ovrEngineered/ovrBeaconGateway-btle-elec/bom/ovrBeaconGateway-btle_pricing.xlsx

Reference | Manufacturer | Man. Part Num. | Supplier | Supplier Part Num. | Quantity | Price (qty 1) | Subtotal (qty 1) | Price (qty 1000) | Subtotal (qty 1000)
U4 | Intersil | ISL32602EFBZ | Digi-Key | ISL32602EFBZ-ND | 1 | $3.18 | $3.18 | $1.680000 | $1.68
U5 | BlueGiga | BLE121LR-A-M256K | Digi-Key | 1446-1039-1-ND | 1 | $13.76 | $13.76 | $8.312320 | $8.31
J1 | Pulse Electronics | E6588-52L184-L | Digi-Key | 553-2265-ND | 1 | $1.40 | $1.40 | $0.774400 | $0.77
R8 R9 R6 R7 R10 R4 R5 | Vishay_Dale | CRCW060310K0FKEA | Digi-Key | 541-10.0KHCT-ND | 7 | $0.10 | $0.70 | $0.003610 | $0.03
U2 | Torex Semiconductor | XC6210B332MR-G | Digi-Key | 893-1075-1-ND | 1 | $0.88 | $0.88 | $0.351020 | $0.35
C1 C2 | Murata | GRM21BR71A106KE51L | Digi-Key | 490-3905-1-ND | 2 | $0.24 | $0.48 | $0.059340 | $0.12
D1 | Lite-On Inc | LTST-C193KGKT-5A | Digi-Key | 160-1828-1-ND | 1 | $0.41 | $0.41 | $0.075650 | $0.08
R1 R2 R3 | Vishay_Dale | CRCW0603402RFKEA | Digi-Key | 541-402HCT-ND | 3 | $0.10 | $0.30 | $0.005540 | $0.02
C4 C5 | Murata | GRM188R71C104KA01D | Digi-Key | 490-1532-1-ND | 2 | $0.10 | $0.20 | $0.004730 | $0.01
C3 | Murata | GRM188R71E103KA01D | Digi-Key | 490-1520-1-ND | 1 | $0.10 | $0.10 | $0.005760 | $0.01
U1 | Silicon Labs | SI7050-A20-IM | Digi-Key | 336-3118-5-ND | 1 | $1.25 | $1.25 | $0.939300 | $0.94
D2 | Lite-On Inc | LTST-C193TBKT-5A | Digi-Key | 160-1827-1-ND | 1 | $0.47 | $0.47 | $0.085700 | $0.09
D3 | Lite-On Inc | LTST-C193KRKT-5A | Digi-Key | 160-1830-1-ND | 1 | $0.41 | $0.41 | $0.075650 | $0.08
Q1 Q2 | International Rectifier | IRLML2402TRPBF | Digi-Key | IRLML2402PBFCT-ND | 2 | $0.43 | $0.86 | $0.105060 | $0.21
U3 | Lite-On | LTR-329ALS-01 | Digi-Key | 160-2160-1-ND | 1 | $1.08 | $1.08 | $0.431060 | $0.43
J2 | Amphenol | 20021111-00010T4LF | Digi-Key | 609-3712-ND | 1 | $0.64 | $0.64 | $0.330990 | $0.33
LightPipe | Visual Communications Company | LFB100CTP | Digi-Key | LFB100CTP-ND | 3 | $0.59 | $1.77 | $0.144040 | $0.43
Case | PolyCase | TF-1521TX | PolyCase | TF-1521TX | 1 | $1.09 | $1.09 | $0.560000 | $0.56
Case Top | PolyCase | C-1502-N | PolyCase | C-1502-N | 1 | $0.61 | $0.61 | $0.300000 | $0.30
Case Print/Machining | PolyCase |  |  |  | 1 |  |  | $3.090000 | $3.09
PCB |  |  |  |  | 1 | $1.00 | $1.00 | $1.000000 | $1.00
Assembly |  |  |  |  | 1 |  |  | $2.000000 | $2.00
 |  |  |  |  |  | Total: | $30.59 |  | $20.82
