ovrEngineered/ovrBeaconGateway-btle-elec/output/ovrBeaconGateway-btle_schematic.pdf

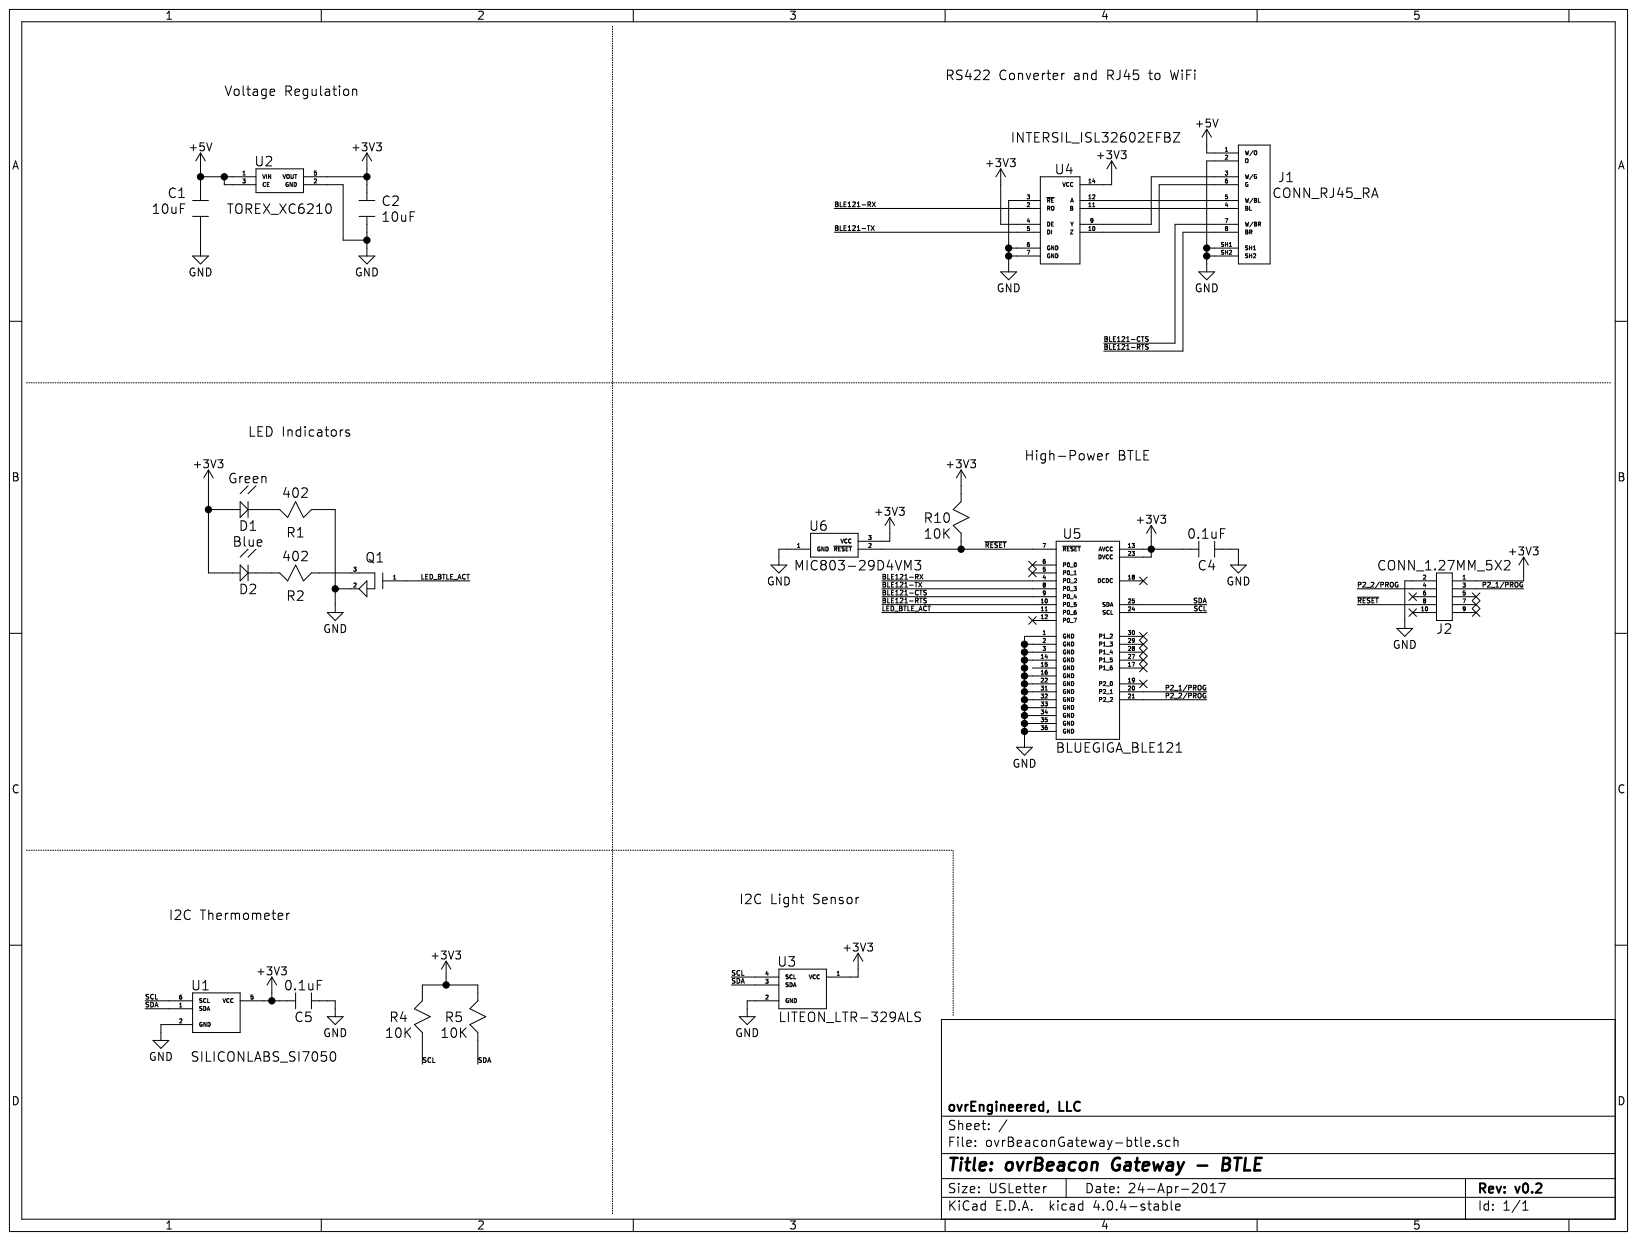
[picture p1: page 1]
