ovrEngineered/ovrBeaconGateway-btle-elec/output/ovrBeaconGateway-btle_layout.pdf

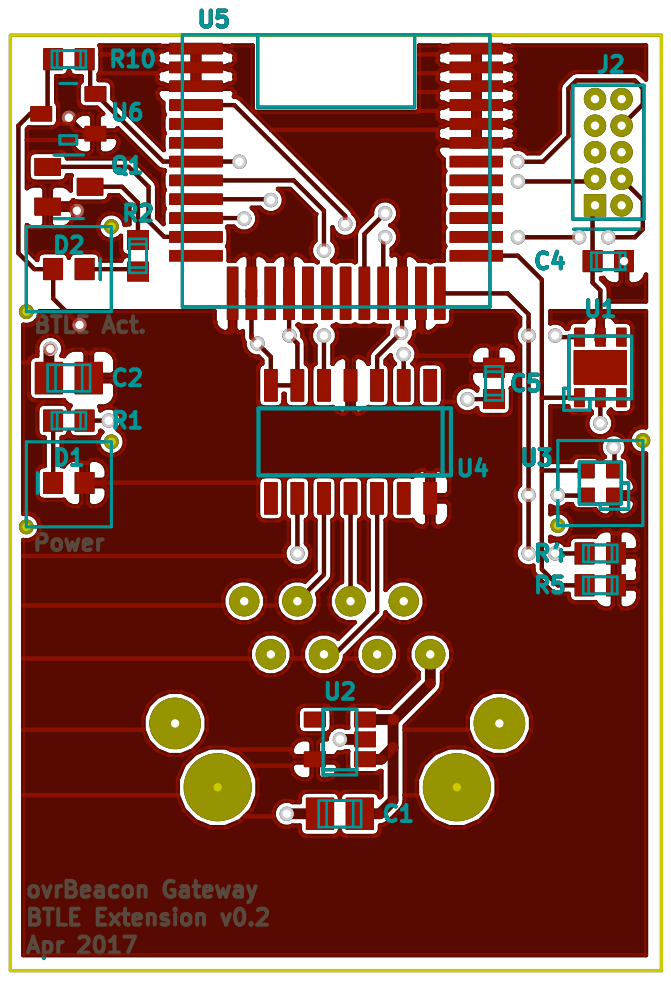
[picture p2: page 1]
