ovrEngineered/ovrBeaconGateway-btle-elec/ovrBeaconGateway-btle.kicad_pcb

## KiCad design ovrBeaconGateway-btle.kicad_pcb (2017-05-01)

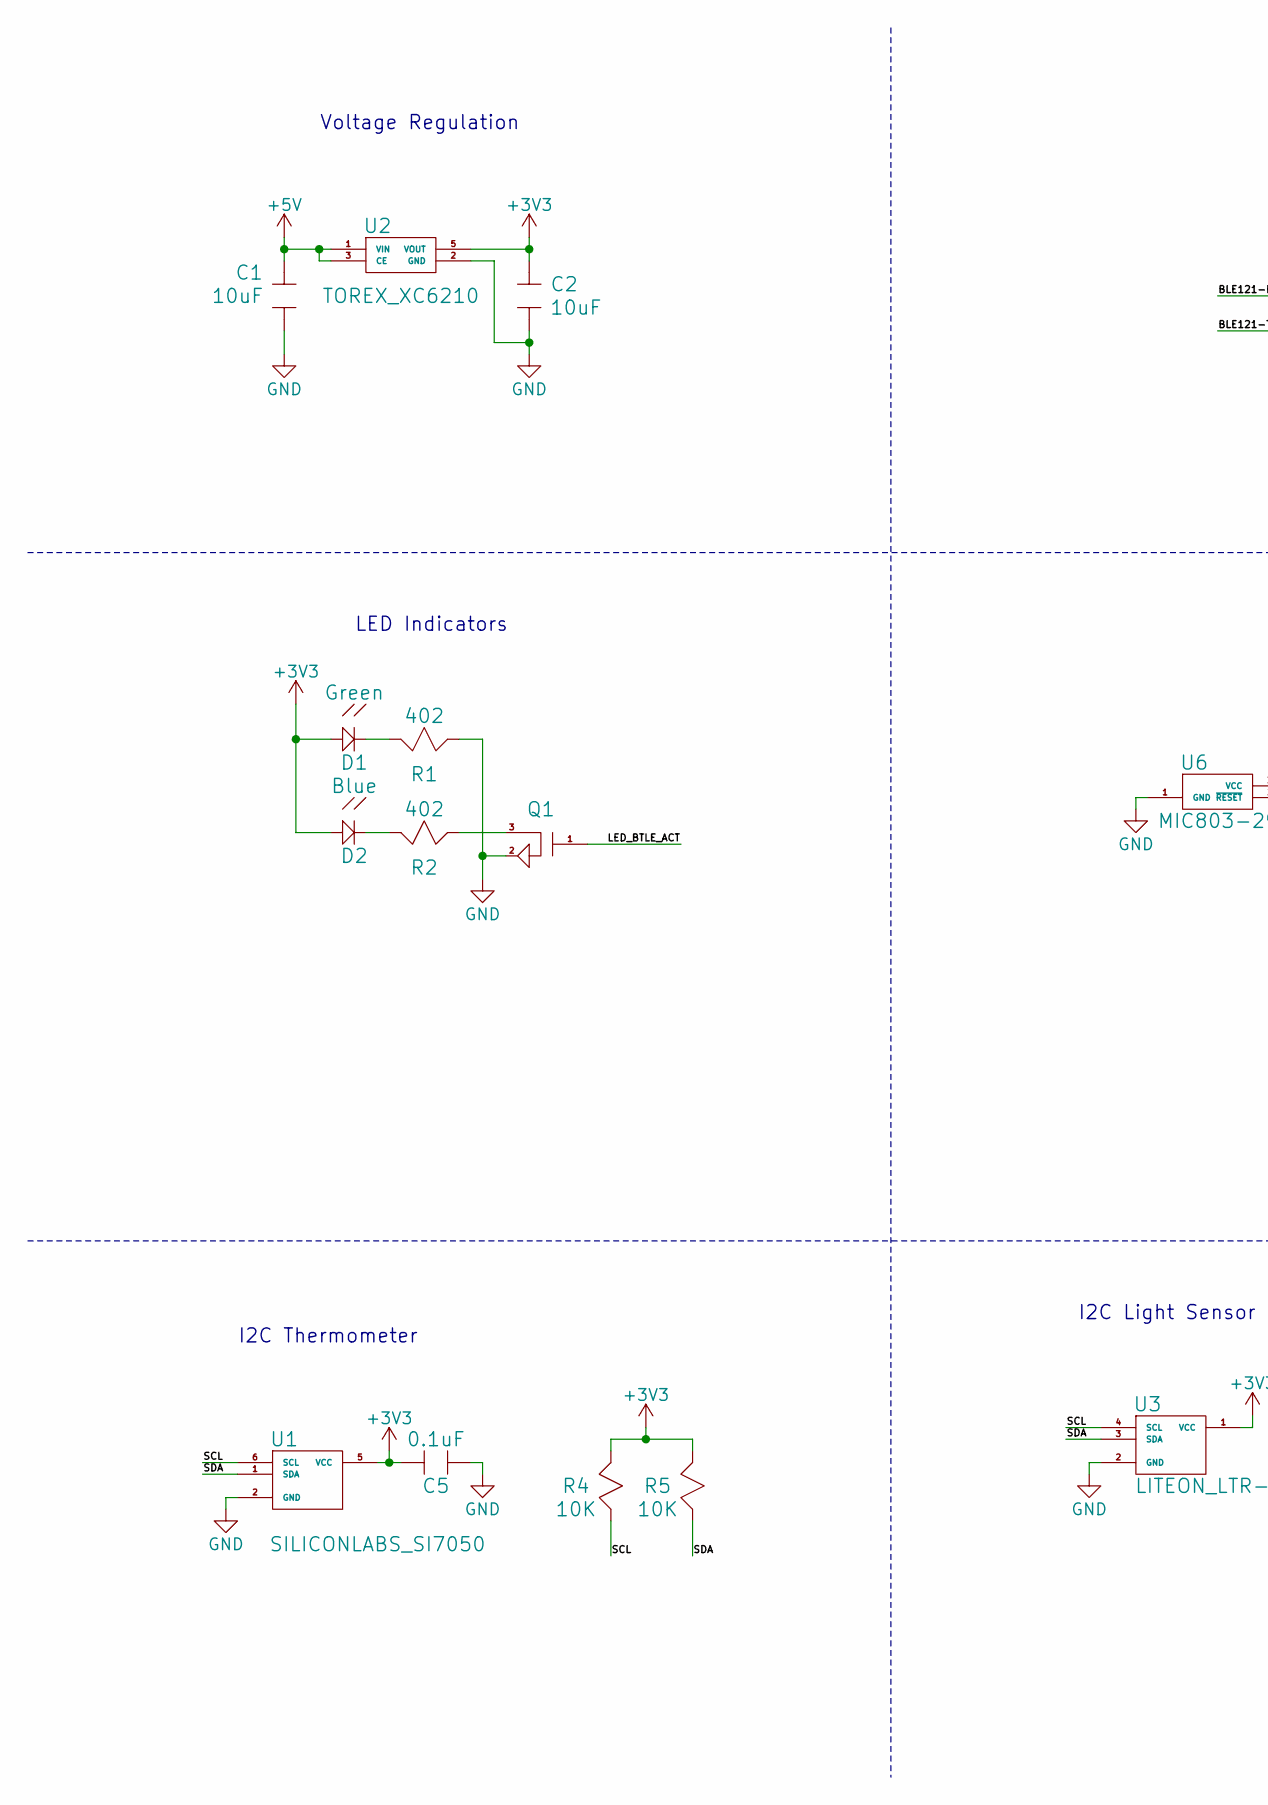
[picture p3: schematic ovrBeaconGateway-btle.sch, ovrBeacon Gateway - BTLE, part in row 1, column 1]

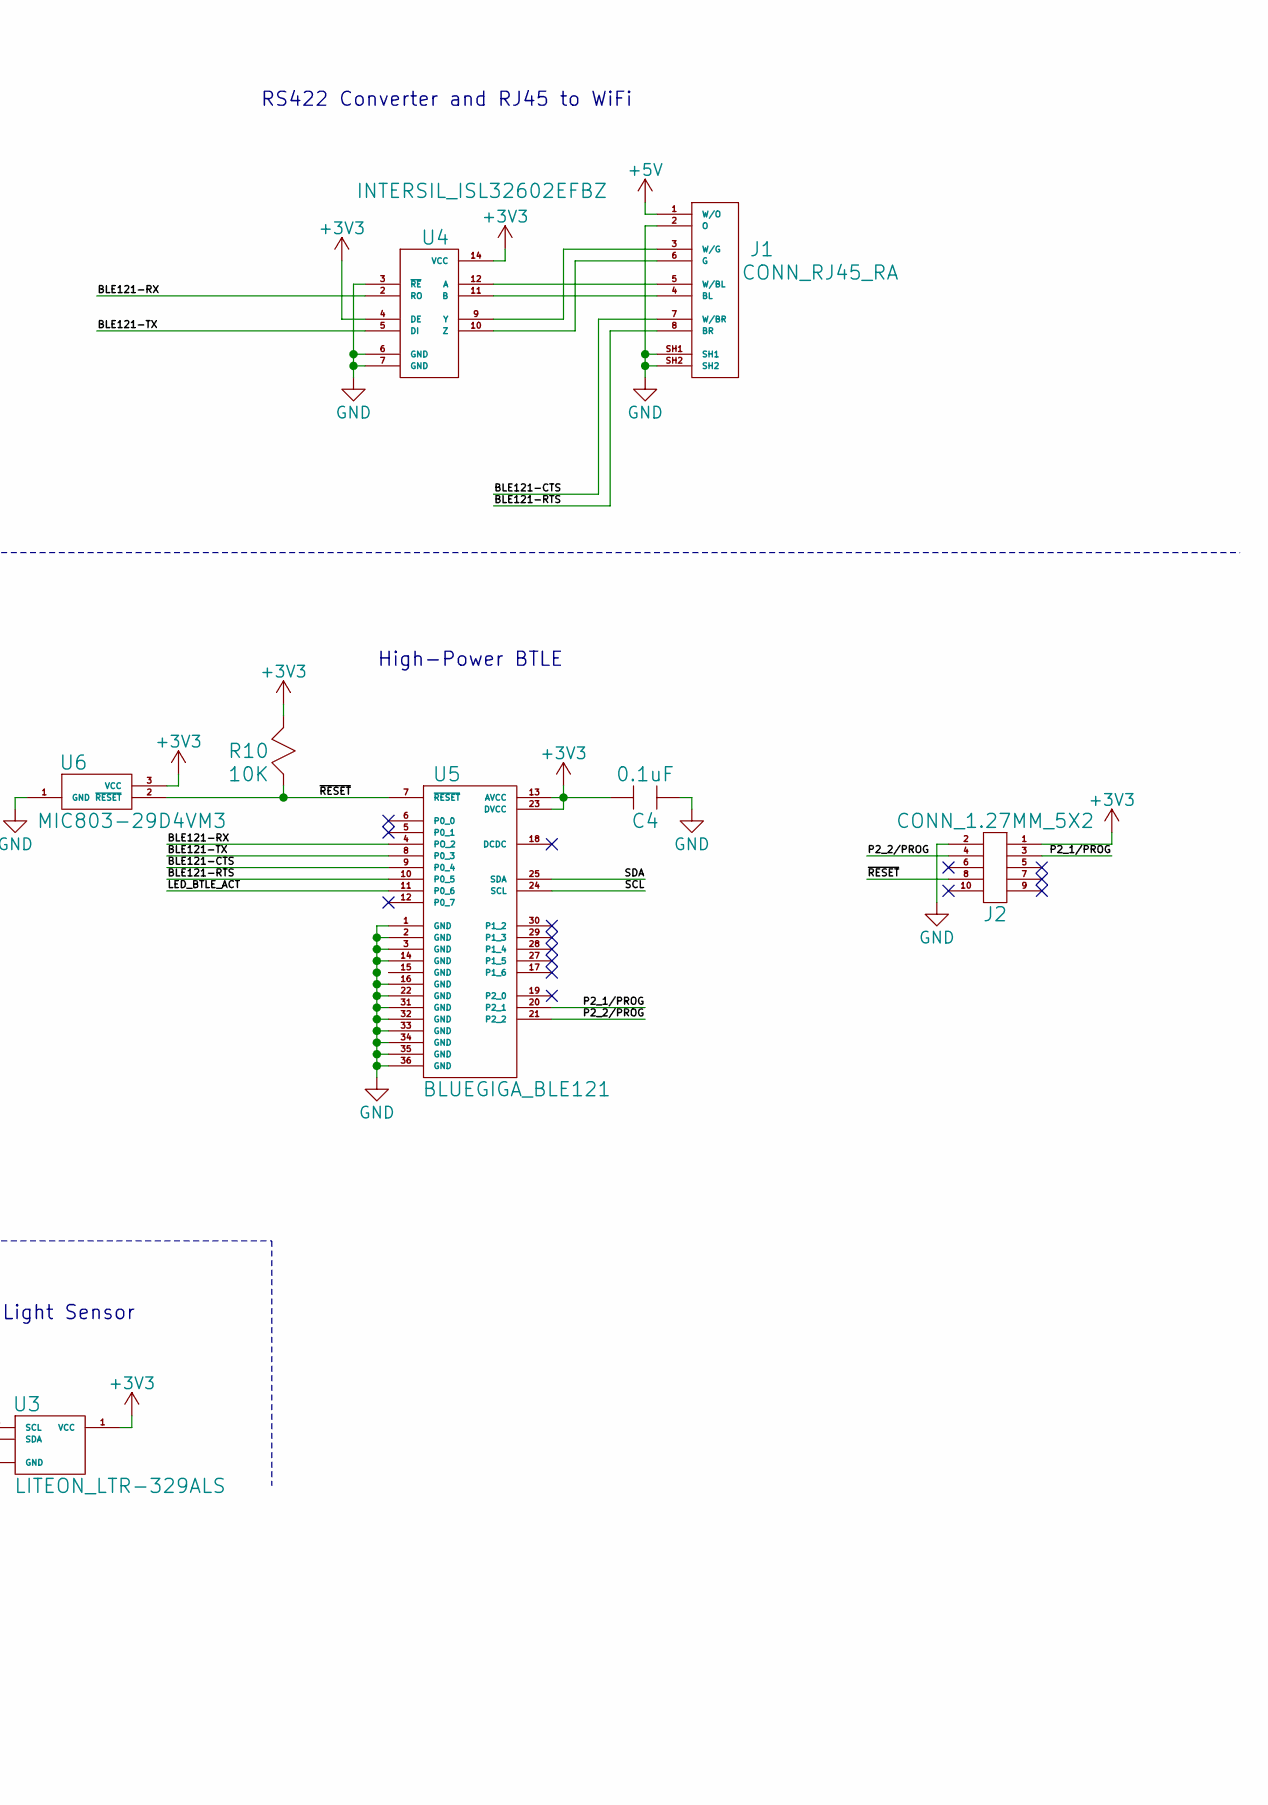
[picture p4: schematic ovrBeaconGateway-btle.sch, ovrBeacon Gateway - BTLE, part in row 1, column 2]

Parts:
C1, C2: C_10uF_10v_0805; C_0805; Man. Part Num. GRM21BR71A106KE51L
C4, C5: C_0.1uF_10v_0603; C_0603; Man. Part Num. GRM188R71C104KA01D
D1: LED_GREEN_0603; D_0603; Man. Part Num. LTST-C193KGKT-5A
D2: LED_BLUE_0603; D_0603; Man. Part Num. LTST-C193TBKT-5A
J1: CONN_RJ45_RA; RJ45_NOMAG_RA; Man. Part Num. E6588-52L184-L
J2: CONN_1.27MM_5X2; 20021111-00010T4LF; Man. Part Num. 20021111-00010T4LF
Q1: FET_N_1.2A_20V; Man. Part Num. IRLML2402TRPBF
R1, R2: R_402_1%_0603; R_0603; Man. Part Num. CRCW0603402RFKEA
R4, R5, R10: R_10K_1%_0603; R_0603; Man. Part Num. CRCW060310K0FKEA
U1: SILICONLABS_SI7050; Man. Part Num. SI7050-A20-IM
U2: TOREX_XC6210; SOT-25-5; Man. Part Num. XC6210B332MR-G
U3: LITEON_LTR-329ALS; Man. Part Num. LTR-329ALS-01
U4: INTERSIL_ISL32602EFBZ; SOIC-14; Man. Part Num. ISL32602EFBZ
U5: BLUEGIGA_BLE121; BLE121; Man. Part Num. BLE121LR-A-M256K
U6: MIC803-29D4VM3; SOT-23-3; Man. Part Num. MIC803-29D4VM3-TR

Connections:
+3V3: C2.1, C4.1, C5.1, D1.1, D2.1, J2.1, R4.1, R5.1, R10.1, U1.5 (VCC), U2.5 (VOUT), U3.1 (VCC), U4.4 (DE), U4.14 (VCC), U5.13 (AVCC), U5.23 (DVCC), U6.3 (VCC)
+5V: C1.1, J1.1 (W/O), U2.1 (VIN), U2.3 (CE)
/BLE121-CTS: J1.7 (W/BR), U5.9 (P0_4)
/BLE121-RTS: J1.8 (BR), U5.10 (P0_5)
/BLE121-RX: U4.2 (RO), U5.4 (PO_2)
/BLE121-TX: U4.5 (DI), U5.8 (P0_3)
/LED_BTLE_ACT: Q1.1, U5.11 (P0_6)
/P2_1/PROG: J2.3, U5.20 (P2_1)
/P2_2/PROG: J2.4, U5.21 (P2_2)
/SCL: R4.2, U1.6 (SCL), U3.4 (SCL), U5.24 (SCL)
/SDA: R5.2, U1.1 (SDA), U3.3 (SDA), U5.25 (SDA)
/~RESET: J2.8, R10.2, U5.7 (~RESET), U6.2 (~RESET)
GND: C1.2, C2.2, C4.2, C5.2, J1.2 (O), J1.SH1, J1.SH2, J2.2, Q1.2, R1.1, U1.2 (GND), U2.2 (GND), U3.2 (GND), U4.3 (~RE), U4.6 (GND), U4.7 (GND), U5.1 (GND), U5.2 (GND), U5.3 (GND), U5.14 (GND), U5.16 (GND), U5.22 (GND), U5.31 (GND), U5.32 (GND), U5.33 (GND), U5.34 (GND), U5.35 (GND), U5.36 (GND), U6.1 (GND)
unnamed: D1.2, R1.2
unnamed: D2.2, R2.2
unnamed: J1.3 (W/G), U4.9 (Y)
unnamed: J1.4 (BL), U4.11 (B)
unnamed: J1.5 (W/BL), U4.12 (A)
unnamed: J1.6 (G), U4.10 (Z)
unnamed: Q1.3, R2.1

Notes on the sheet:
Voltage Regulation
LED Indicators
RS422 Converter and RJ45 to WiFi
High-Power BTLE
I2C Light Sensor
I2C Thermometer

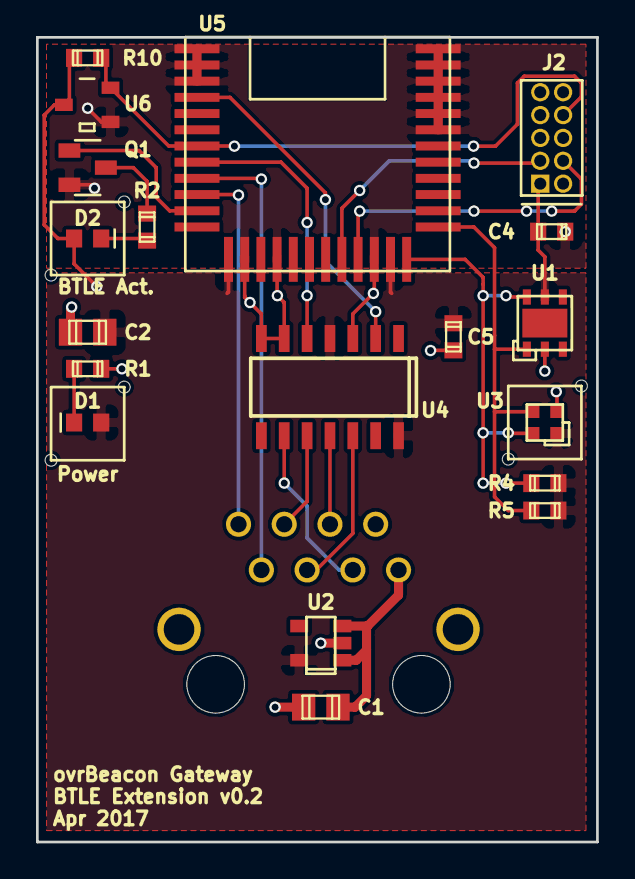
[picture p5: board ovrBeaconGateway-btle.kicad_pcb from above]

Board: 2 copper layers, 31.1 x 44.7 mm, 20 parts (1 on the bottom side), 20 nets.
