ovrEngineered/ovrBeaconGateway-btle-elec/(commit log)

2017-02-26 Initial commit…ready for DFM
    [_saved_ovrBeaconGateway-btle.sch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]
2017-02-26 Added pricing and BOM
    [_saved_ovrBeaconGateway-btle.sch, ovrBeaconGateway-btle.sch, ovrBeaconGateway-btle_BOM.csv, ovrBeaconGateway-btle_pricing.xlsx]
2017-02-26 Added schematic and layout PDF
2017-03-07 Updated pricing document w/ variants
    [ovrBeaconGateway-btle_pricing.xlsx]
2017-05-01 Out for DFM
    [ovrBeaconGateway-btle-B.Cu.gbr, ovrBeaconGateway-btle-B.Mask.gbr, ovrBeaconGateway-btle-B.SilkS.gbr, ovrBeaconGateway-btle-Dwgs.User.gbr, ovrBeaconGateway-btle-Edge.Cuts.gbr, ovrBeaconGateway-btle-F.Cu.gbr, ovrBeaconGateway-btle-F.Mask.gbr, ovrBeaconGateway-btle-F.SilkS.gbr]
